Allegra42/ZEReader-KiCad/pictures/ze-back.png

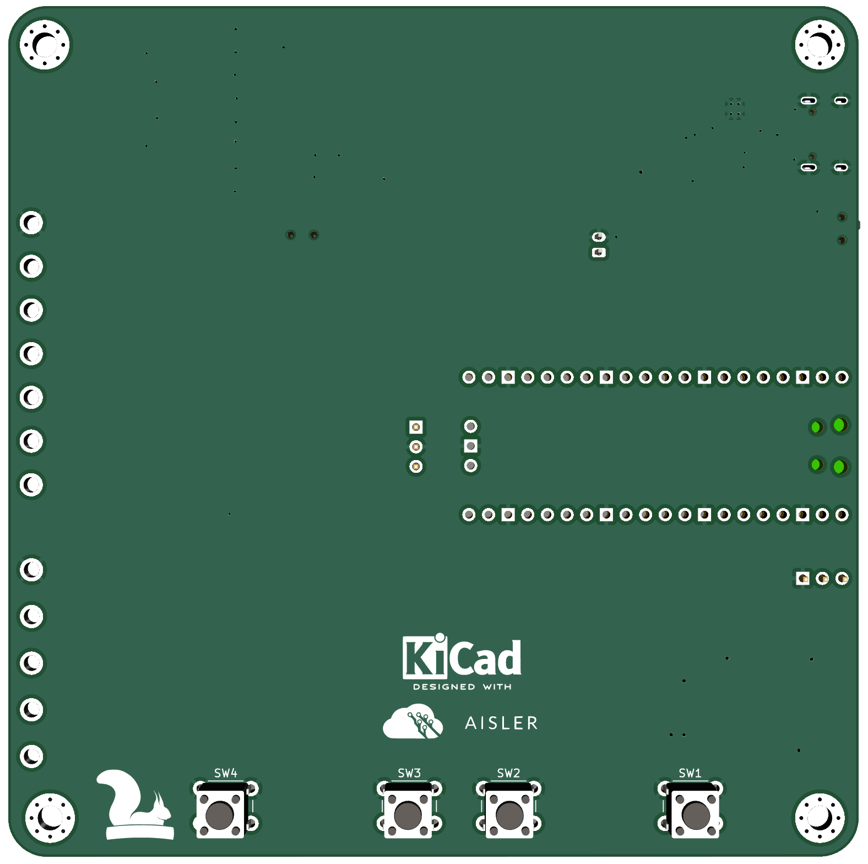
pictures/ze-back.png
