Allegra42/ZEReader-KiCad/pictures/ze-front.png

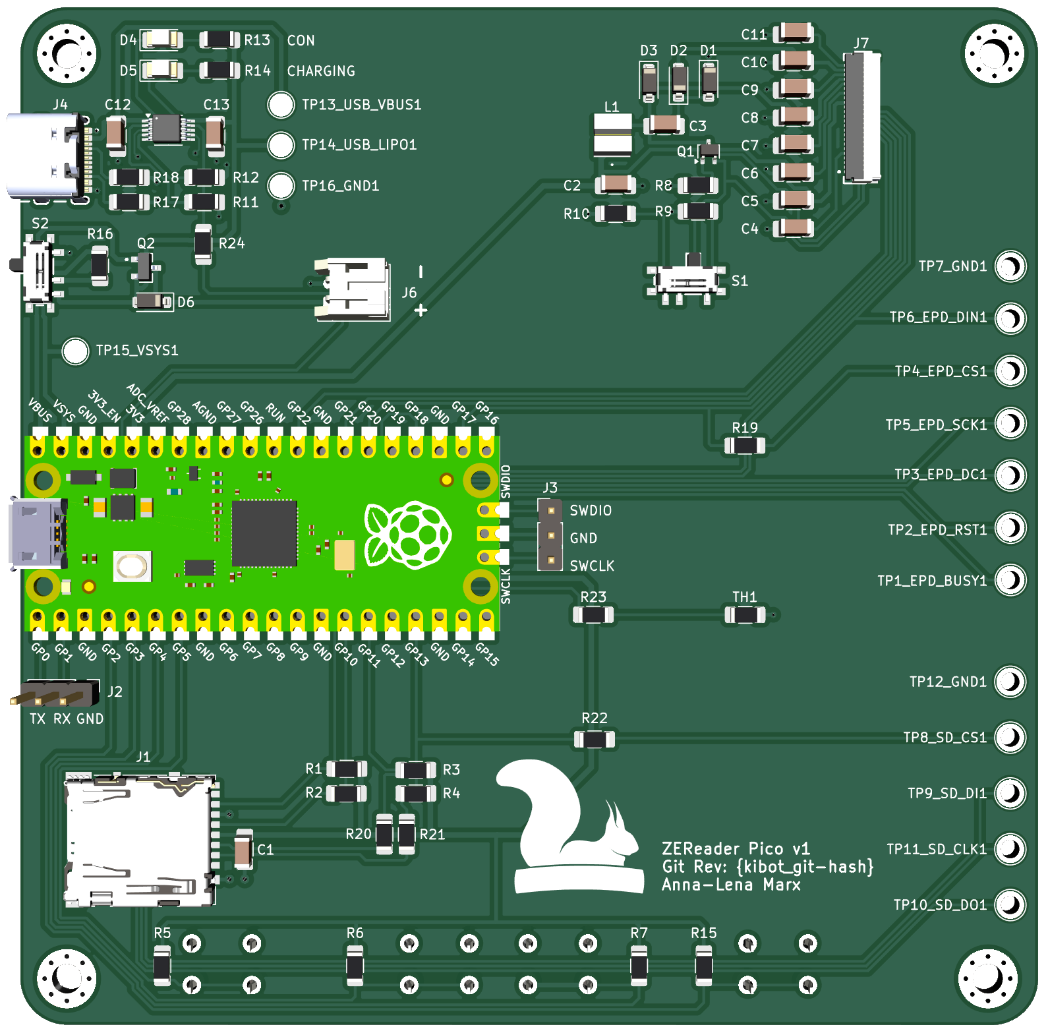
pictures/ze-front.png
