Allegra42/ZEReader-KiCad/pictures/ze-pcb.png

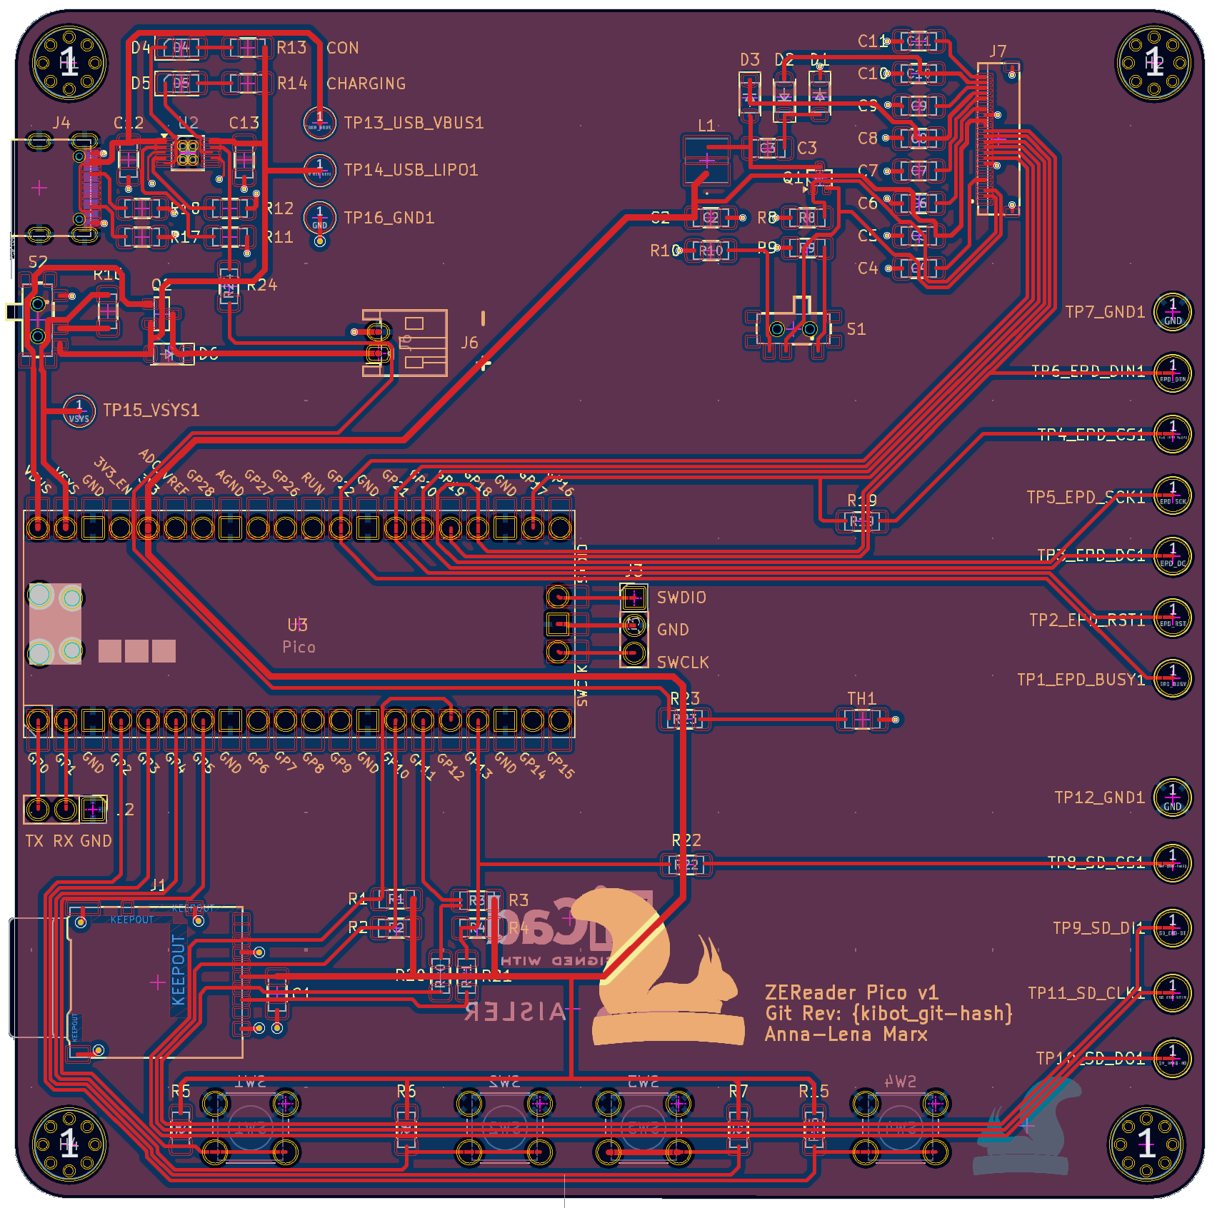
pictures/ze-pcb.png
