Allegra42/ZEReader-KiCad/pictures/ze-ray-back.png

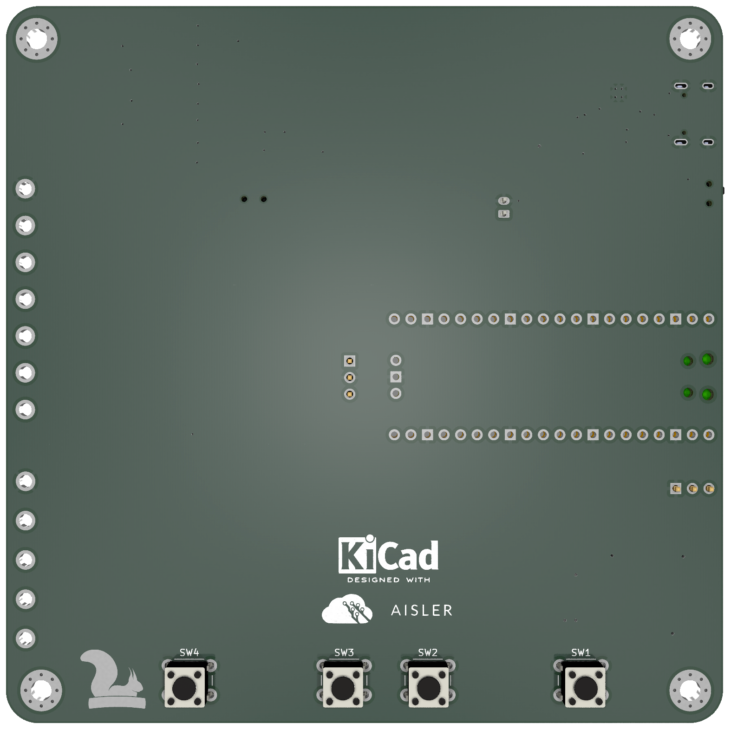
pictures/ze-ray-back.png
