Allegra42/ZEReader-KiCad/pictures/ZEReader-Pico v2-back.png

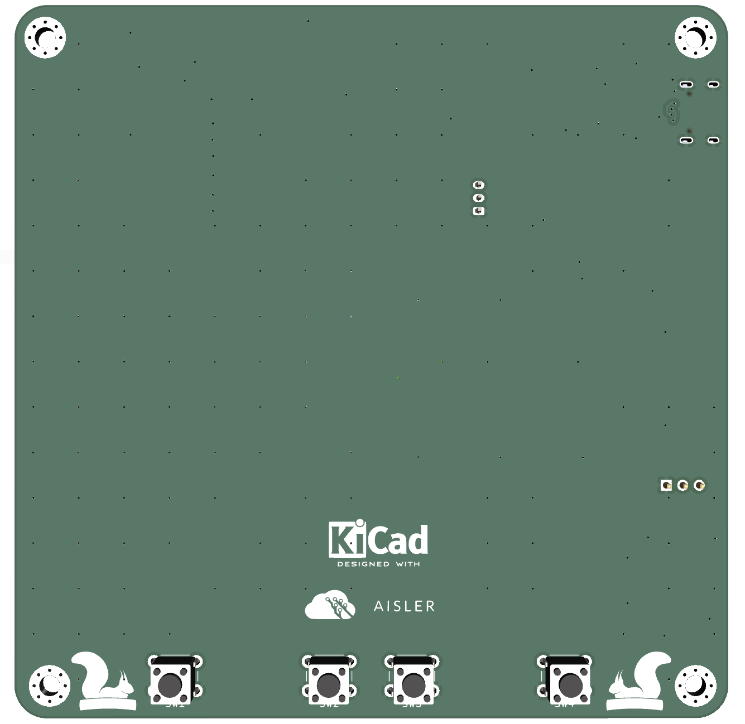
pictures/ZEReader-Pico v2-back.png
