Allegra42/ZEReader-KiCad/ZEReader-Pico.kicad_pcb

## KiCad design ZEReader-Pico.kicad_pcb (2026-01-08)

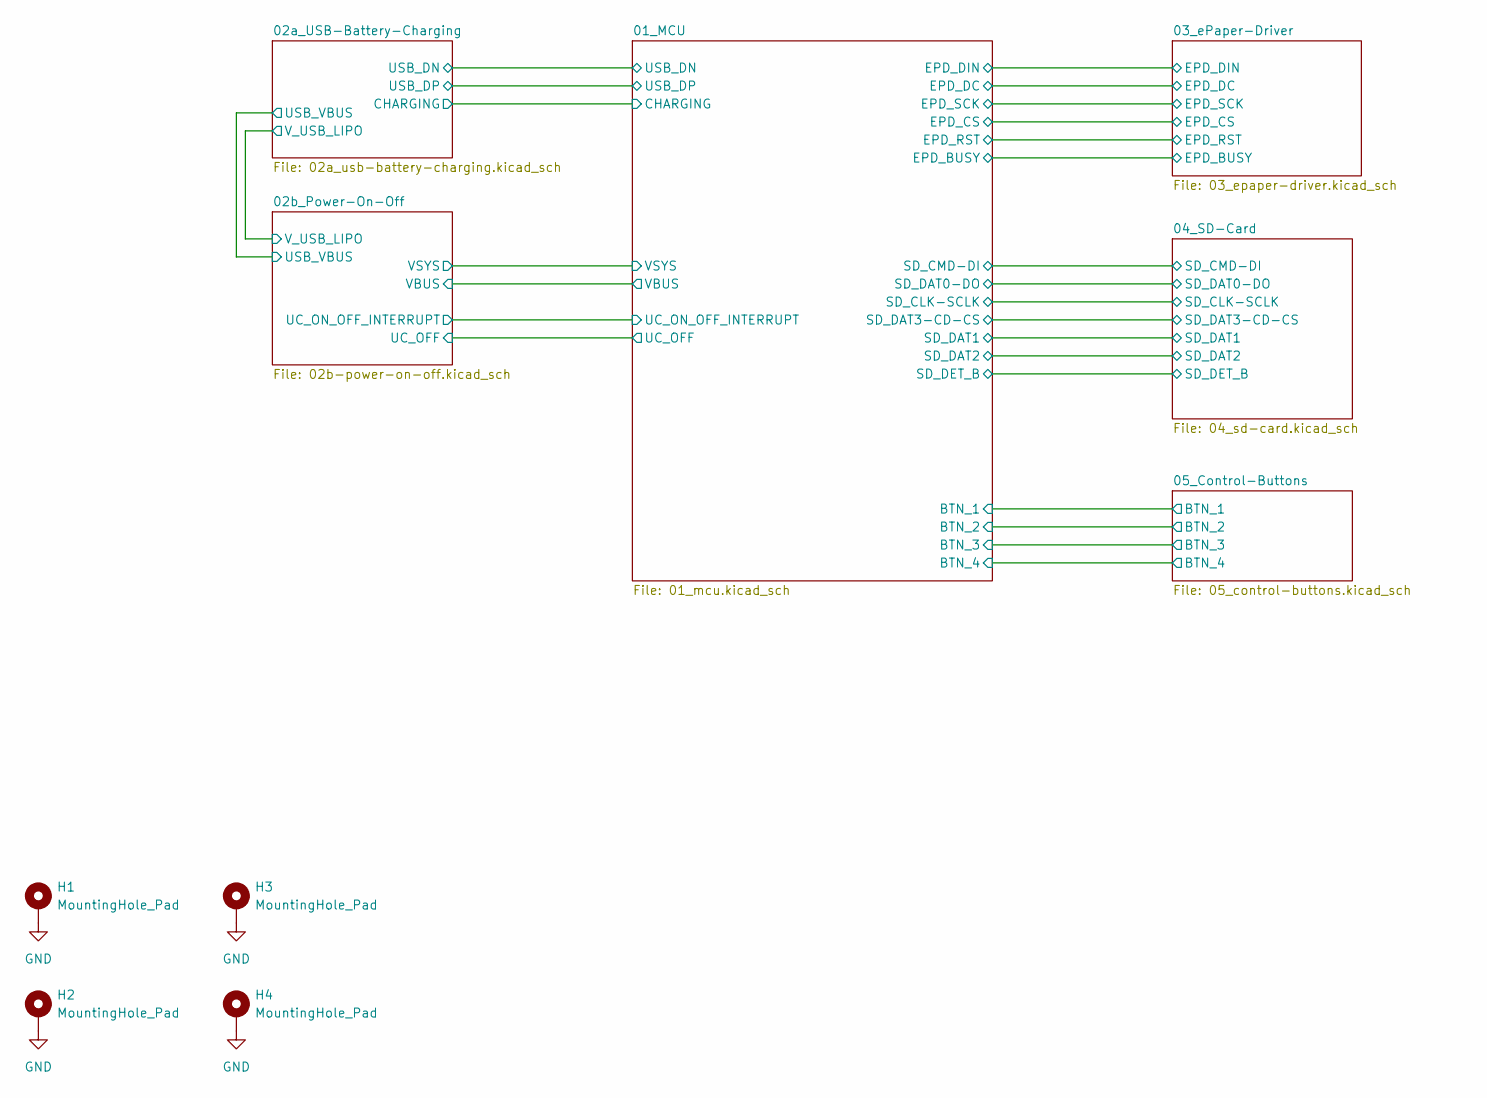
[picture p8: schematic ZEReader-Pico.kicad_sch]

Parts:
H1, H2, H3, H4: MountingHole_Pad; MountingHole_3.2mm_M3_Pad_Via

Connections:
GND: H1.1, H2.1, H3.1, H4.1; also elsewhere on the board

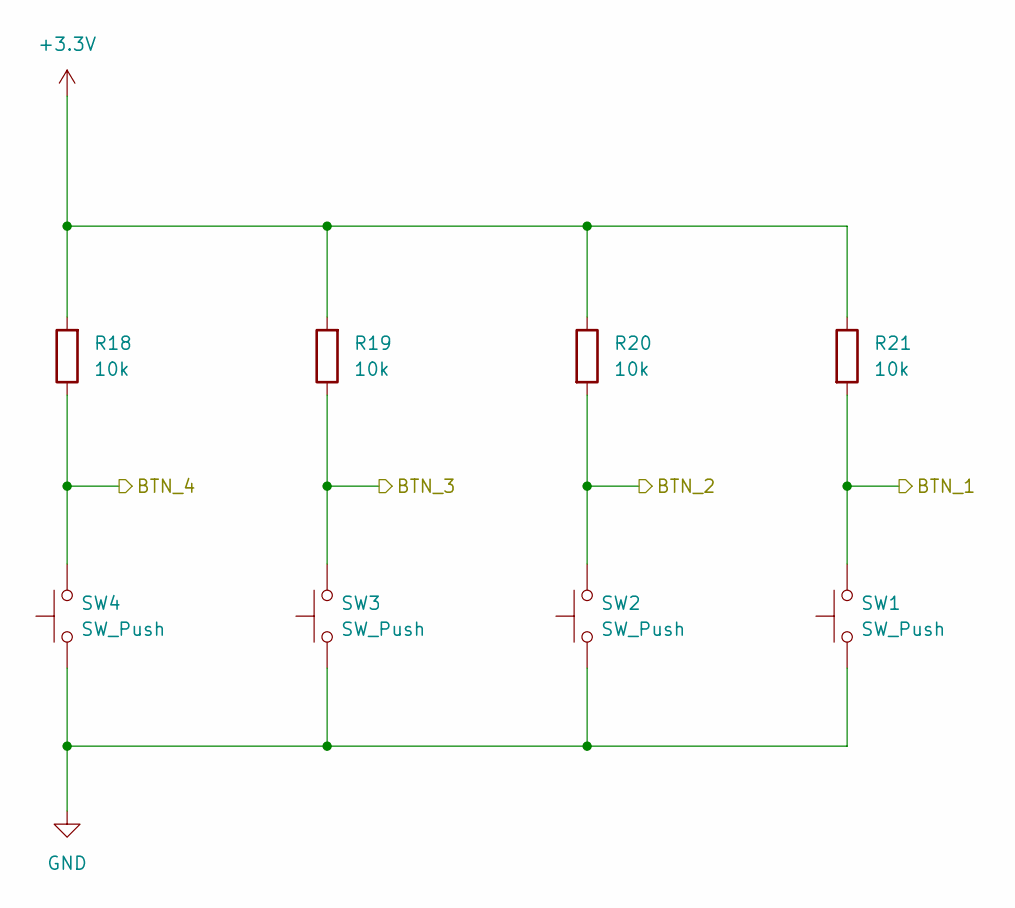
[picture p9: schematic 05_control-buttons.kicad_sch, ZEReader-Pico]

Parts:
R18, R19, R20, R21: 10k; R_1206_3216Metric_Pad1.30x1.75mm_HandSolder; Manufacturer PartNo RC1206FR-0710KL; DigiKey 311-10.0KFRCT-ND
SW1, SW2, SW3, SW4: SW_Push; SW_PUSH_6mm; Manufacturer PartNo 1825910-6; DigiKey 450-1650-ND

Connections:
+3.3V: R18.2, R19.2, R20.1, R21.1; also elsewhere on the board
/01_MCU/BTN_1: R21.2, SW1.2; also elsewhere on the board
/01_MCU/BTN_2: R20.2, SW2.2; also elsewhere on the board
/01_MCU/BTN_3: R19.1, SW3.2; also elsewhere on the board
/01_MCU/BTN_4: R18.1, SW4.2; also elsewhere on the board
GND: SW1.1, SW2.1, SW3.1, SW4.1; also elsewhere on the board

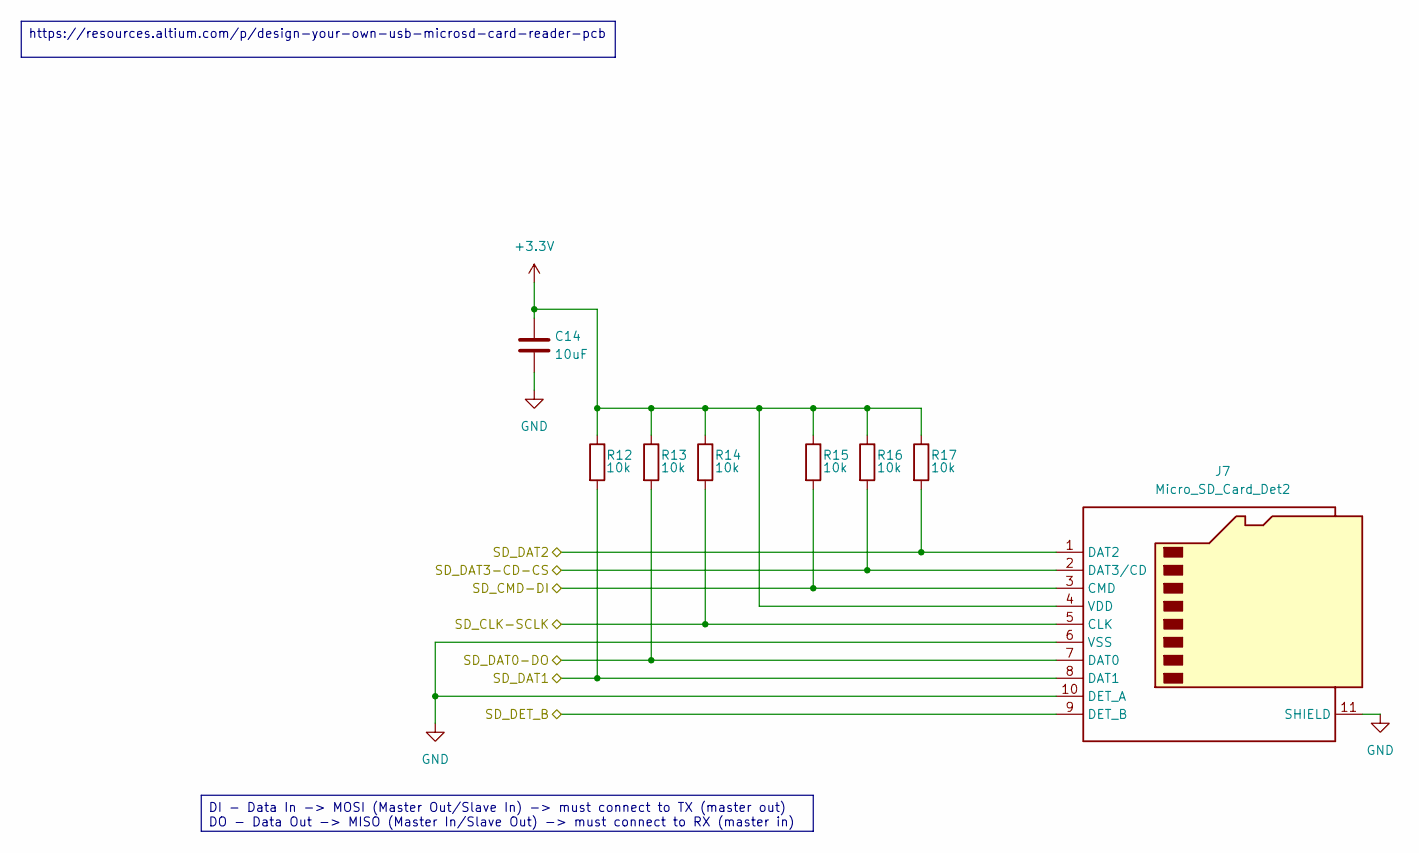
[picture p10: schematic 04_sd-card.kicad_sch, ZEReader-Pico]

Parts:
C14: 10uF; C_1206_3216Metric_Pad1.33x1.80mm_HandSolder; Manufacturer PartNo CL31B106KAHNNNE; DigiKey 1276-1804-1-ND
J7: Micro_SD_Card_Det2; microSD_HC_Hirose_DM3AT-SF-PEJM5; Manufacturer PartNo DM3AT-SF-PEJM5; DigiKey HR1964CT-ND
R12, R13, R14, R15, R16, R17: 10k; R_1206_3216Metric_Pad1.30x1.75mm_HandSolder; Manufacturer PartNo RC1206FR-0710KL; DigiKey 311-10.0KFRCT-ND

Connections:
+3.3V: C14.1, J7.4 (VDD), R12.1, R13.1, R14.1, R15.1, R16.1, R17.1; also elsewhere on the board
/01_MCU/SD_CLK-SCLK: J7.5 (CLK), R14.2; also elsewhere on the board
/01_MCU/SD_CMD-DI: J7.3 (CMD), R15.2; also elsewhere on the board
/01_MCU/SD_DAT0-DO: J7.7 (DAT0), R13.2; also elsewhere on the board
/01_MCU/SD_DAT1: J7.8 (DAT1), R12.2; also elsewhere on the board
/01_MCU/SD_DAT2: J7.1 (DAT2), R17.2; also elsewhere on the board
/01_MCU/SD_DAT3-CD-CS: J7.2 (DAT3/CD), R16.2; also elsewhere on the board
/01_MCU/SD_DET_B: J7.9 (DET_B); also elsewhere on the board
GND: C14.2, J7.6 (VSS), J7.10 (DET_A), J7.11 (SHIELD); also elsewhere on the board

Notes on the sheet:
DI - Data In -> MOSI (Master Out/Slave In) -> must connect to TX (master out) DO - Data Out -> MISO (Master In/Slave Out) -> must connect to RX (master in)
https://resources.altium.com/p/design-your-own-usb-microsd-card-reader-pcb

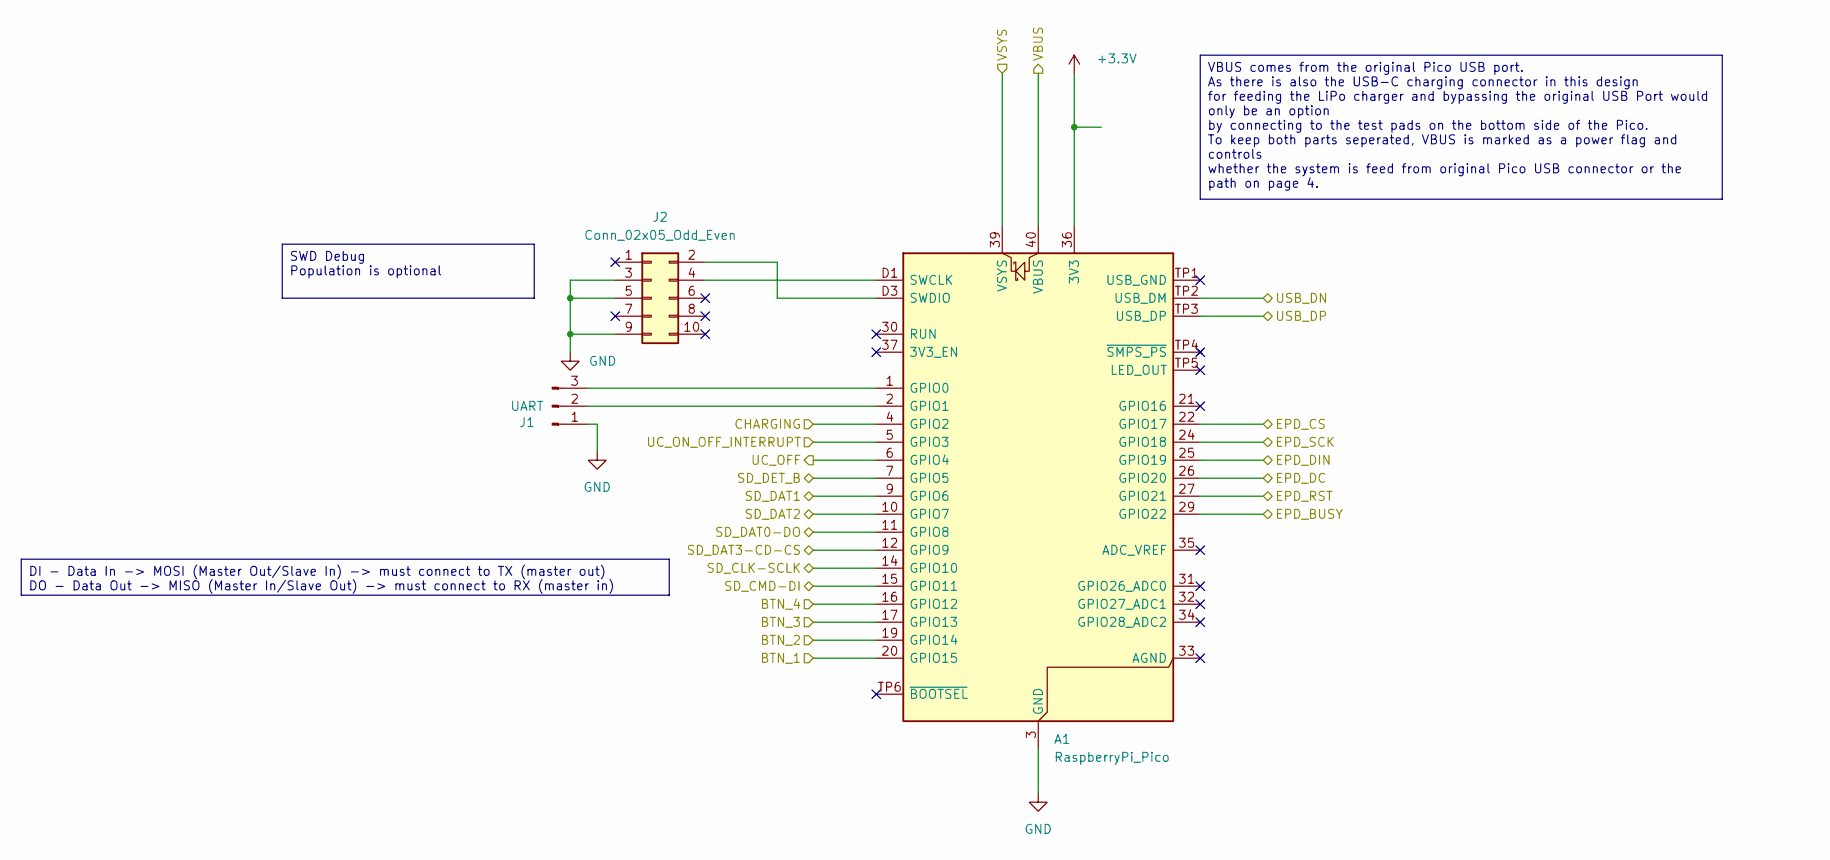
[picture p11: schematic 01_mcu.kicad_sch, ZEReader-Pico]

Parts:
A1: RaspberryPi_Pico; RaspberryPi_Pico_SMD; Manufacturer PartNo SC1631; DigiKey 2648-SC1631CT-ND
J1: UART; PinHeader_1x03_P2.54mm_Vertical; Manufacturer PartNo G800W305018EU; DigiKey 664-G800W305018EU-ND
J2: Conn_02x05_Odd_Even; PinHeader_2x05_P1.27mm_Vertical_SMD; Manufacturer PartNo BD125-10-A-0305-0580-L-B; DigiKey 2073-BD125-10-A-0305-0580-L-BCT-ND

Connections:
+3.3V: A1.36 (3V3); also elsewhere on the board
/01_MCU/BTN_1: A1.20 (GPIO15); also elsewhere on the board
/01_MCU/BTN_2: A1.19 (GPIO14); also elsewhere on the board
/01_MCU/BTN_3: A1.17 (GPIO13); also elsewhere on the board
/01_MCU/BTN_4: A1.16 (GPIO12); also elsewhere on the board
/01_MCU/CHARGING: A1.4 (GPIO2); also elsewhere on the board
/01_MCU/EPD_BUSY: A1.29 (GPIO22); also elsewhere on the board
/01_MCU/EPD_CS: A1.22 (GPIO17); also elsewhere on the board
/01_MCU/EPD_DC: A1.26 (GPIO20); also elsewhere on the board
/01_MCU/EPD_DIN: A1.25 (GPIO19); also elsewhere on the board
/01_MCU/EPD_RST: A1.27 (GPIO21); also elsewhere on the board
/01_MCU/EPD_SCK: A1.24 (GPIO18); also elsewhere on the board
/01_MCU/SD_CLK-SCLK: A1.14 (GPIO10); also elsewhere on the board
/01_MCU/SD_CMD-DI: A1.15 (GPIO11); also elsewhere on the board
/01_MCU/SD_DAT0-DO: A1.11 (GPIO8); also elsewhere on the board
/01_MCU/SD_DAT1: A1.9 (GPIO6); also elsewhere on the board
/01_MCU/SD_DAT2: A1.10 (GPIO7); also elsewhere on the board
/01_MCU/SD_DAT3-CD-CS: A1.12 (GPIO9); also elsewhere on the board
/01_MCU/SD_DET_B: A1.7 (GPIO5); also elsewhere on the board
/01_MCU/UC_OFF: A1.6 (GPIO4); also elsewhere on the board
/01_MCU/UC_ON_OFF_INTERRUPT: A1.5 (GPIO3); also elsewhere on the board
/01_MCU/USB_DN: A1.TP2 (USB_DM); also elsewhere on the board
/01_MCU/USB_DP: A1.TP3 (USB_DP); also elsewhere on the board
/01_MCU/VBUS: A1.40 (VBUS); also elsewhere on the board
/01_MCU/VSYS: A1.39 (VSYS); also elsewhere on the board
GND: A1.3 (GND), A1.8 (GND), A1.13 (GND), A1.18 (GND), A1.23 (GND), A1.28 (GND), A1.38 (GND), A1.D2 (GND), J1.1, J2.3, J2.5, J2.9; also elsewhere on the board
unnamed: A1.1 (GPIO0), J1.3
unnamed: A1.2 (GPIO1), J1.2
unnamed: A1.D1 (SWCLK), J2.4
unnamed: A1.D3 (SWDIO), J2.2

Notes on the sheet:
VBUS comes from the original Pico USB port. As there is also the USB-C charging connector in this design for feeding the LiPo charger and bypassing the original USB Port would only be an option by connecting to the test pads on the bottom side of the Pico. To keep both parts seperated, VBUS is mark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
DI - Data In -> MOSI (Master Out/Slave In) -> must connect to TX (master out) DO - Data Out -> MISO (Master In/Slave Out) -> must connect to RX (master in)
SWD Debug Population is optional

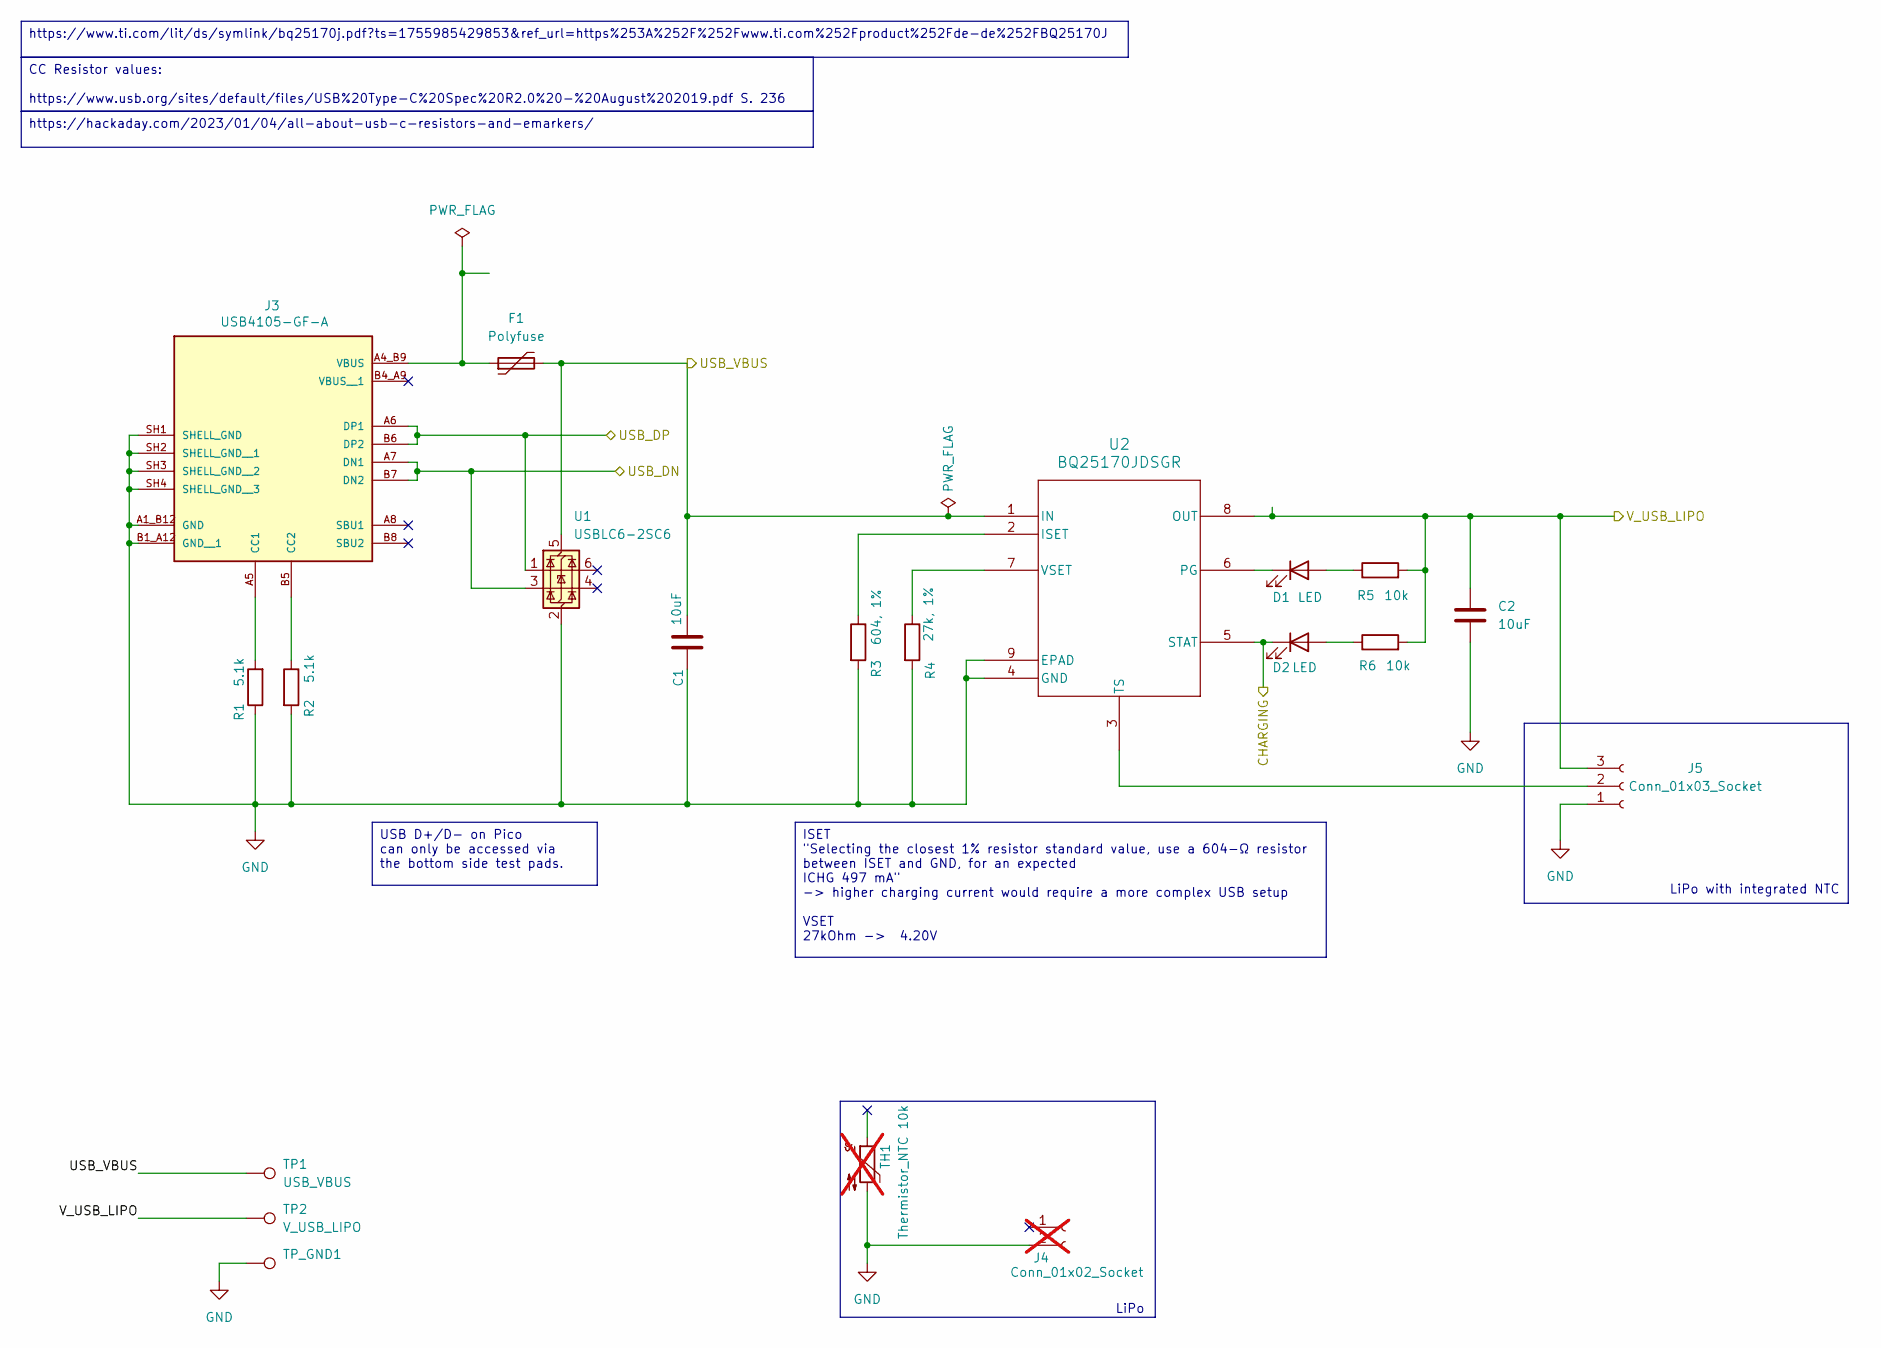
[picture p12: schematic 02a_usb-battery-charging.kicad_sch, ZEReader-Pico]

Parts:
C1, C2: 10uF; C_1206_3216Metric_Pad1.33x1.80mm_HandSolder; Manufacturer PartNo CL31B106KAHNNNE; DigiKey 1276-1804-1-ND
D1: LED; LED_1206_3216Metric_Pad1.42x1.75mm_HandSolder; Manufacturer PartNo 150120YS75000; DigiKey 732-4994-1-ND
D2: LED; LED_1206_3216Metric_Pad1.42x1.75mm_HandSolder; Manufacturer PartNo 150120GS75000; DigiKey 732-4990-1-ND
F1: Polyfuse; R_1206_3216Metric_Pad1.30x1.75mm_HandSolder; Manufacturer PartNo 1206L050/15YR; DigiKey F3733CT-ND
J3: USB4105-GF-A; GCT_USB4105-GF-A; PARTREV B4; DigiKey 2073-USB4105-GF-ACT-ND
J4: Conn_01x02_Socket; JST_PH_S2B-PH-K_1x02_P2.00mm_Horizontal; not fitted
J5: Conn_01x03_Socket; JST_PH_S3B-PH-K_1x03_P2.00mm_Horizontal; Manufacturer PartNo S3B-PH-K-S; DigiKey 455-1720-ND
R1, R2: 5.1k; R_1206_3216Metric_Pad1.30x1.75mm_HandSolder; Manufacturer PartNo AC1206FR-075K1L; DigiKey YAG3894CT-ND
R3: 604, 1%; R_1206_3216Metric_Pad1.30x1.75mm_HandSolder; Manufacturer PartNo RNCP1206FTD604R; DigiKey RNCP1206FTD604RCT-ND
R4: 27k, 1%; R_1206_3216Metric_Pad1.30x1.75mm_HandSolder; Manufacturer PartNo RC1206FR-0727KL; DigiKey 311-27.0KFRCT-ND
R5, R6: 10k; R_1206_3216Metric_Pad1.30x1.75mm_HandSolder; Manufacturer PartNo RC1206FR-0710KL; DigiKey 311-10.0KFRCT-ND
TH1: Thermistor_NTC 10k; R_1206_3216Metric_Pad1.30x1.75mm_HandSolder; not fitted
TP1: USB_VBUS; TestPoint_Pad_D2.5mm
TP2: V_USB_LIPO; TestPoint_Pad_D2.5mm
TP_GND1: TestPoint_Pad_D2.5mm
U1: USBLC6-2SC6; SOT-23-6; Manufacturer PartNo USBLC6-2SC6; DigiKey 497-5235-1-ND
U2: BQ25170JDSGR; WSON8_BQ2517_TEX; Manufacturer PartNo BQ25170JDSGR; DigiKey 296-BQ25170JDSGRCT-ND

Connections:
/01_MCU/CHARGING: D2.1 (K), U2.5 (STAT); also elsewhere on the board
/01_MCU/USB_DN: J3.A7 (DN1), J3.B7 (DN2), U1.3 (I/O2); also elsewhere on the board
/01_MCU/USB_DP: J3.A6 (DP1), J3.B6 (DP2), U1.1 (I/O1); also elsewhere on the board
/02a_USB-Battery-Charging/USB_VBUS: C1.1, F1.2, TP1.1, U1.5 (VBUS), U2.1 (IN); also elsewhere on the board
/02a_USB-Battery-Charging/V_USB_LIPO: C2.1, J5.3, R5.2, R6.2, TP2.1, U2.8 (OUT); also elsewhere on the board
GND: C1.2, C2.2, J3.A1_B12 (GND), J3.B1_A12 (GND__1), J3.SH1 (SHELL_GND), J3.SH2 (SHELL_GND__1), J3.SH3 (SHELL_GND__2), J3.SH4 (SHELL_GND__3), J4.2, J5.1, R1.1, R2.2, R3.2, R4.2, TH1.2, TP_GND1.1, U1.2 (GND), U2.4 (GND), U2.9 (EPAD); also elsewhere on the board
unnamed: D1.2 (A), R5.1
unnamed: D1.1 (K), U2.6 (PG)
unnamed: D2.2 (A), R6.1
unnamed: J3.A5 (CC1), R1.2
unnamed: J3.B5 (CC2), R2.1
unnamed: F1.1, J3.A4_B9 (VBUS)
unnamed: J5.2, U2.3 (TS)
unnamed: R3.1, U2.2 (ISET)
unnamed: R4.1, U2.7 (VSET)

Notes on the sheet:
LiPo
LiPo with integrated NTC
CC Resistor values: https://www.usb.org/sites/default/files/USB%20Type-C%20Spec%20R2.0%20-%20August%202019.pdf S. 236
ISET "Selecting the closest 1% resistor standard value, use a 604-Ω resistor between ISET and GND, for an expected ICHG 497 mA" -> higher charging current would require a more complex USB setup VSET 27kOhm -> 4.20V
https://www.ti.com/lit/ds/symlink/bq25170j.pdf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
https://hackaday.com/2023/01/04/all-about-usb-c-resistors-and-emarkers/
USB D+/D- on Pico can only be accessed via the bottom side test pads.

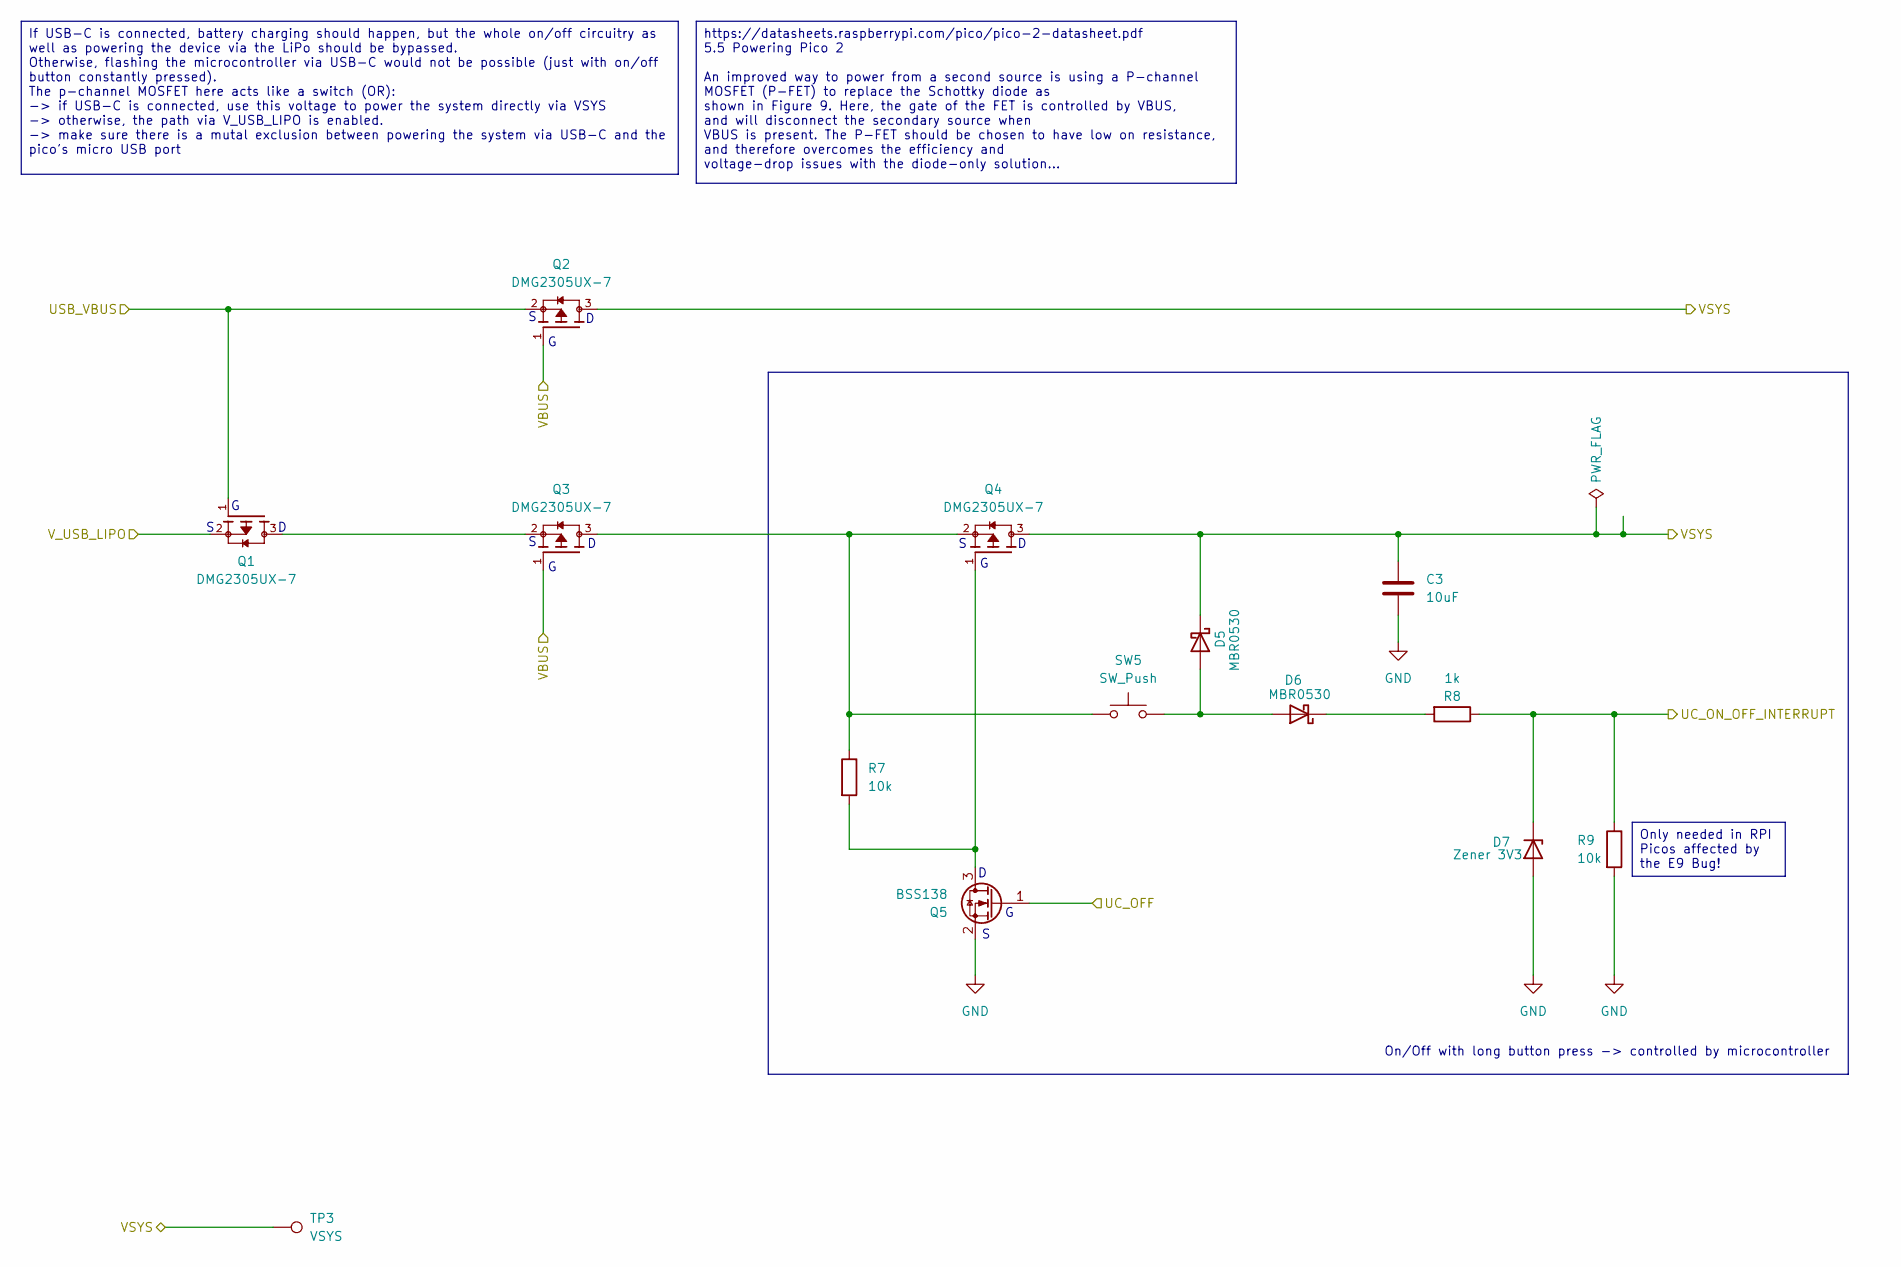
[picture p13: schematic 02b-power-on-off.kicad_sch]

Parts:
C3: 10uF; C_1206_3216Metric_Pad1.33x1.80mm_HandSolder; Manufacturer PartNo CL31B106KAHNNNE; DigiKey 1276-1804-1-ND
D5, D6: MBR0530; D_SOD-123; Manufacturer PartNo MBR0530T1G; DigiKey MBR0530T1GOSCT-ND
D7: Zener 3V3; DIO_TDZVT_ROM; Manufacturer PartNo TFZVTR3.3B; DigiKey TFZVTR3.3BCT-ND
Q1, Q2, Q3, Q4: DMG2305UX-7; SOT-23-3; PARTREV 09/2018; DigiKey DMG2305UX-7DICT-ND
Q5: BSS138; SOT-23; Manufacturer PartNo BSS138LT3G; DigiKey BSS138LT3GOSCT-ND
R7, R9: 10k; R_1206_3216Metric_Pad1.30x1.75mm_HandSolder; Manufacturer PartNo RC1206FR-0710KL; DigiKey 311-10.0KFRCT-ND
R8: 1k; R_1206_3216Metric_Pad1.30x1.75mm_HandSolder; Manufacturer PartNo RNCP1206FTD1K00; DigiKey RNCP1206FTD1K00CT-ND
SW5: SW_Push; SW_Push_1P1T_NO_E-Switch_TL3301NxxxxxG; Manufacturer PartNo TL3301NF100QG; DigiKey EG6054CT-ND
TP3: VSYS; TestPoint_Pad_D2.5mm

Connections:
/01_MCU/UC_OFF: Q5.1 (G); also elsewhere on the board
/01_MCU/UC_ON_OFF_INTERRUPT: D7.1 (K), R8.1, R9.1; also elsewhere on the board
/01_MCU/VBUS: Q2.1, Q3.1; also elsewhere on the board
/01_MCU/VSYS: C3.1, D5.1 (K), Q2.3, Q4.3, TP3.1; also elsewhere on the board
/02a_USB-Battery-Charging/USB_VBUS: Q1.1, Q2.2; also elsewhere on the board
/02a_USB-Battery-Charging/V_USB_LIPO: Q1.2; also elsewhere on the board
GND: C3.2, D7.2 (A), Q5.2 (S), R9.2; also elsewhere on the board
unnamed: D5.2 (A), D6.2 (A), SW5.2
unnamed: D6.1 (K), R8.2
unnamed: Q1.3, Q3.2
unnamed: Q3.3, Q4.2, R7.1, SW5.1
unnamed: Q4.1, Q5.3 (D), R7.2

Notes on the sheet:
On/Off with long button press -> controlled by microcontroller
If USB-C is connected, battery charging should happen, but the whole on/off circuitry as well as powering the device via the LiPo should be bypassed. Otherwise, flashing the microcontroller via USB-C would not be possible (just with on/off button constantly pressed). The p-channel MOSFET here acts 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
https://datasheets.raspberrypi.com/pico/pico-2-datasheet.pdf 5.5 Powering Pico 2 An improved way to power from a second source is using a P-channel MOSFET (P-FET) to replace the Schottky diode as shown in Figure 9. Here, the gate of the FET is controlled by VBUS, and will disconnect the secondary s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
Only needed in RPI Picos affected by the E9 Bug!

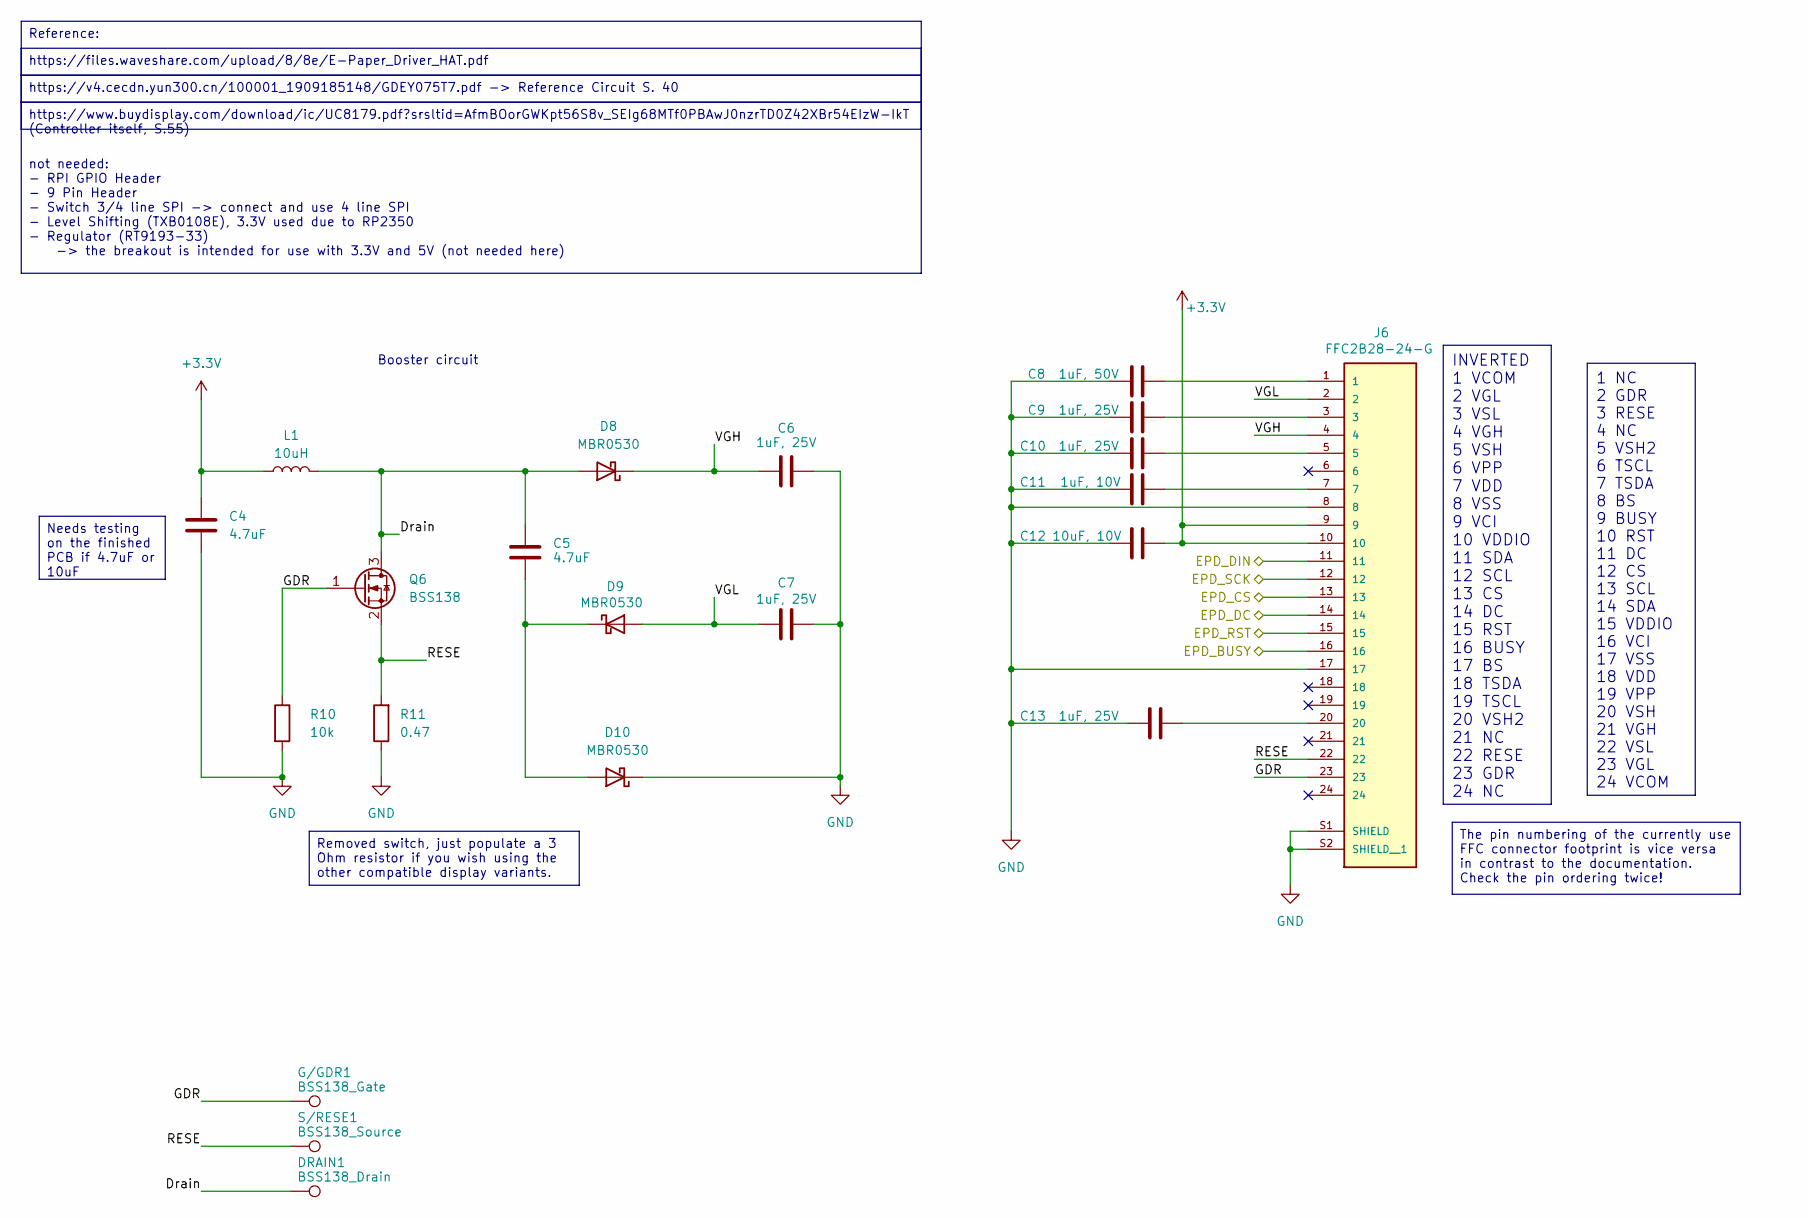
[picture p14: schematic 03_epaper-driver.kicad_sch, ZEReader-Pico]

Parts:
C4, C5: 4.7uF; C_1206_3216Metric_Pad1.33x1.80mm_HandSolder; Manufacturer PartNo CL31B475KBHNFNE; DigiKey 1276-3179-1-ND
C6, C7, C9, C10, C13: 1uF, 25V; C_1206_3216Metric_Pad1.33x1.80mm_HandSolder; Manufacturer PartNo CL31B105KBHNFNE; DigiKey 1276-3091-1-ND
C8: 1uF, 50V; C_1206_3216Metric_Pad1.33x1.80mm_HandSolder; Manufacturer PartNo CL31B105KBHNFNE; DigiKey 1276-3091-1-ND
C11: 1uF, 10V; C_1206_3216Metric_Pad1.33x1.80mm_HandSolder; Manufacturer PartNo CL31B105KBHNFNE; DigiKey 1276-3091-1-ND
C12: 10uF, 10V; C_1206_3216Metric_Pad1.33x1.80mm_HandSolder; Manufacturer PartNo CL31B106KAHNNNE; DigiKey 1276-1804-1-ND
D8, D9, D10: MBR0530; D_SOD-123; Manufacturer PartNo MBR0530T1G; DigiKey MBR0530T1GOSCT-ND
DRAIN1: BSS138_Drain; TestPoint_Pad_D2.5mm
G/GDR1: BSS138_Gate; TestPoint_Pad_D2.5mm
J6: FFC2B28-24-G; GCT_FFC2B28-24-G; PARTREV A; DigiKey 2073-FFC2B28-24-GCT-ND
L1: 10uH; IND_IFSC_1515AH_VIS-L; Manufacturer PartNo IFSC1515AHER100M01; DigiKey 541-1406-1-ND
Q6: BSS138; SOT-23; Manufacturer PartNo BSS138LT3G; DigiKey BSS138LT3GOSCT-ND
R10: 10k; R_1206_3216Metric_Pad1.30x1.75mm_HandSolder; Manufacturer PartNo RC1206FR-0710KL; DigiKey 311-10.0KFRCT-ND
R11: 0.47; R_1206_3216Metric_Pad1.30x1.75mm_HandSolder; Manufacturer PartNo KDV12DR470ET; DigiKey 273-KDV12DR470ETCT-ND
S/RESE1: BSS138_Source; TestPoint_Pad_D2.5mm

Connections:
+3.3V: C4.1, C12.2, J6.9, J6.10, L1.1; also elsewhere on the board
/01_MCU/EPD_BUSY: J6.16; also elsewhere on the board
/01_MCU/EPD_CS: J6.13; also elsewhere on the board
/01_MCU/EPD_DC: J6.14; also elsewhere on the board
/01_MCU/EPD_DIN: J6.11; also elsewhere on the board
/01_MCU/EPD_RST: J6.15; also elsewhere on the board
/01_MCU/EPD_SCK: J6.12; also elsewhere on the board
/03_ePaper-Driver/Drain: C5.1, D8.2 (A), DRAIN1.1, L1.2, Q6.3 (D)
/03_ePaper-Driver/GDR: G/GDR1.1, J6.23, Q6.1 (G), R10.1
/03_ePaper-Driver/RESE: J6.22, Q6.2 (S), R11.2, S/RESE1.1
/03_ePaper-Driver/VGH: C6.1, D8.1 (K), J6.4
/03_ePaper-Driver/VGL: C7.1, D9.2 (A), J6.2
GND: C4.2, C6.2, C7.2, C8.1, C9.1, C10.1, C11.1, C12.1, C13.1, D10.1 (K), J6.8, J6.17, J6.S1 (SHIELD), J6.S2 (SHIELD__1), R10.2, R11.1; also elsewhere on the board
unnamed: C8.2, J6.1
unnamed: C9.2, J6.3
unnamed: C10.2, J6.5
unnamed: C11.2, J6.7
unnamed: C13.2, J6.20
unnamed: C5.2, D9.1 (K), D10.2 (A)

Notes on the sheet:
Booster circuit
https://files.waveshare.com/upload/8/8e/E-Paper_Driver_HAT.pdf
INVERTED 1 VCOM 2 VGL 3 VSL 4 VGH 5 VSH 6 VPP 7 VDD 8 VSS 9 VCI 10 VDDIO 11 SDA 12 SCL 13 CS 14 DC 15 RST 16 BUSY 17 BS 18 TSDA 19 TSCL 20 VSH2 21 NC 22 RESE 23 GDR 24 NC
https://v4.cecdn.yun300.cn/100001_1909185148/GDEY075T7.pdf -> Reference Circuit S. 40
Needs testing on the finished PCB if 4.7uF or 10uF
https://www.buydisplay.com/download/ic/UC8179.pdf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 (Controller itself, S.55)
Removed switch, just populate a 3 Ohm resistor if you wish using the other compatible display variants.
The pin numbering of the currently use FFC connector footprint is vice versa in contrast to the documentation. Check the pin ordering twice!
1 NC 2 GDR 3 RESE 4 NC 5 VSH2 6 TSCL 7 TSDA 8 BS 9 BUSY 10 RST 11 DC 12 CS 13 SCL 14 SDA 15 VDDIO 16 VCI 17 VSS 18 VDD 19 VPP 20 VSH 21 VGH 22 VSL 23 VGL 24 VCOM
Reference: not needed: - RPI GPIO Header - 9 Pin Header - Switch 3/4 line SPI -> connect and use 4 line SPI - Level Shifting (TXB0108E), 3.3V used due to RP2350 - Regulator (RT9193-33) -> the breakout is intended for use with 3.3V and 5V (not needed here)
