Allegra42/ZEReader-KiCad/ZEReader-Pico.kicad_pcb

## KiCad design ZEReader-Pico.kicad_pcb (continued)

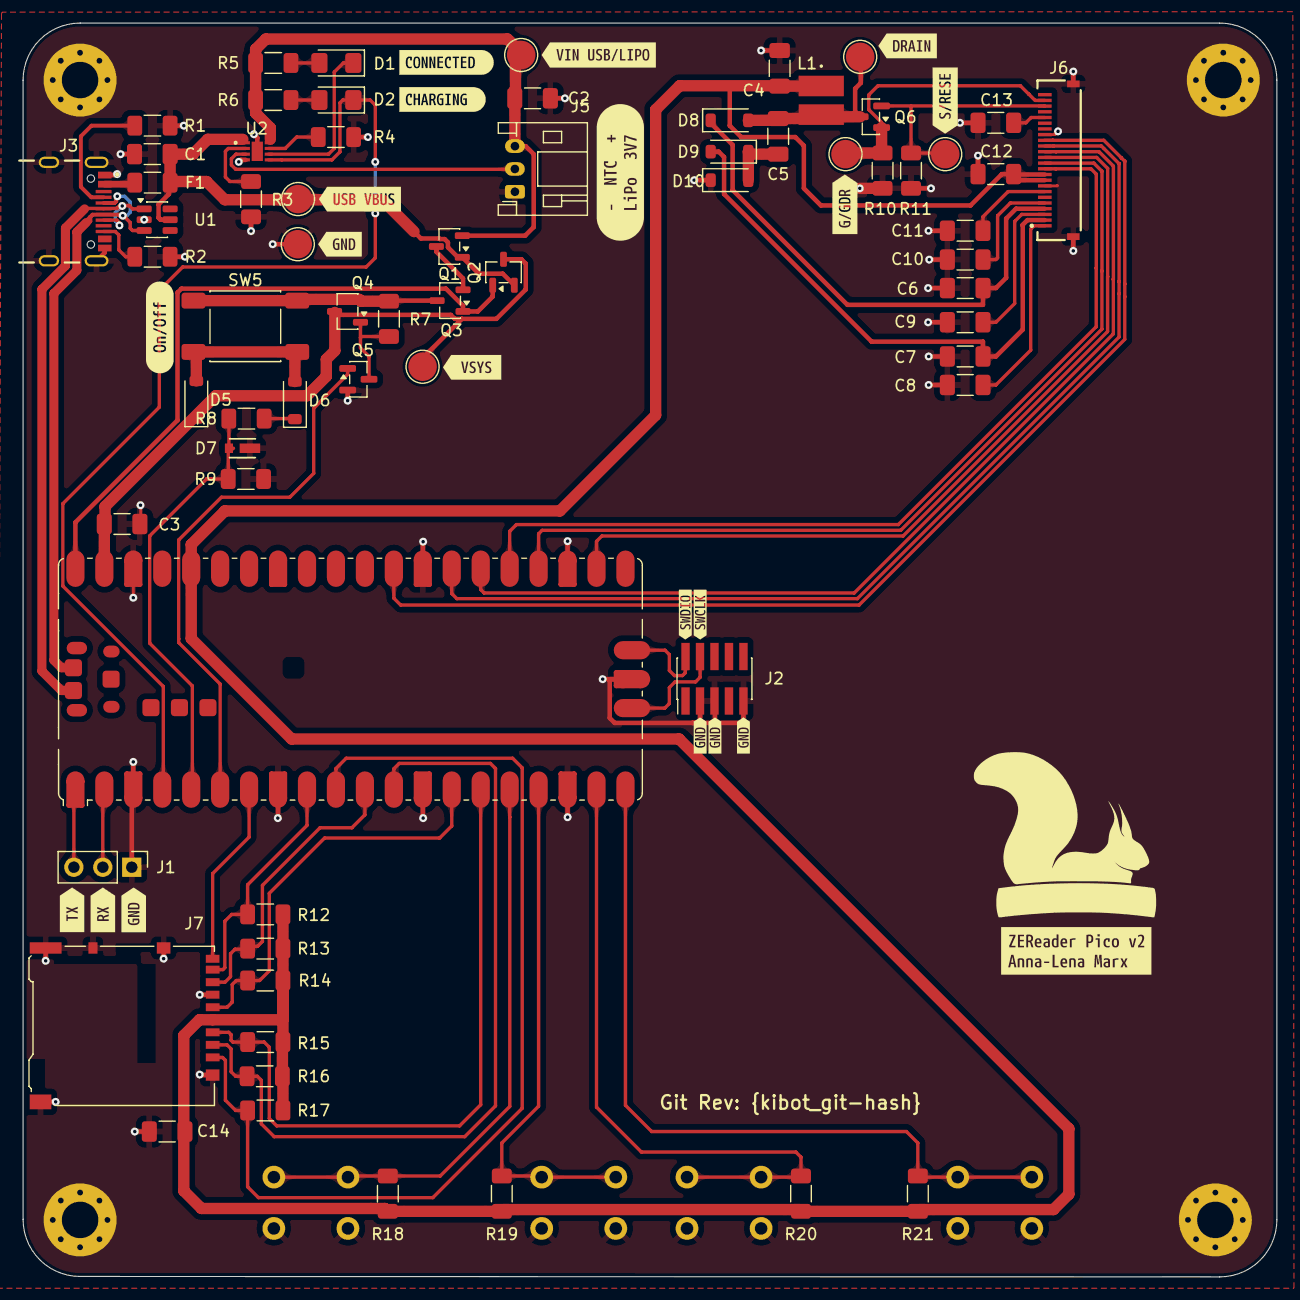
[picture p15: board ZEReader-Pico.kicad_pcb from above]

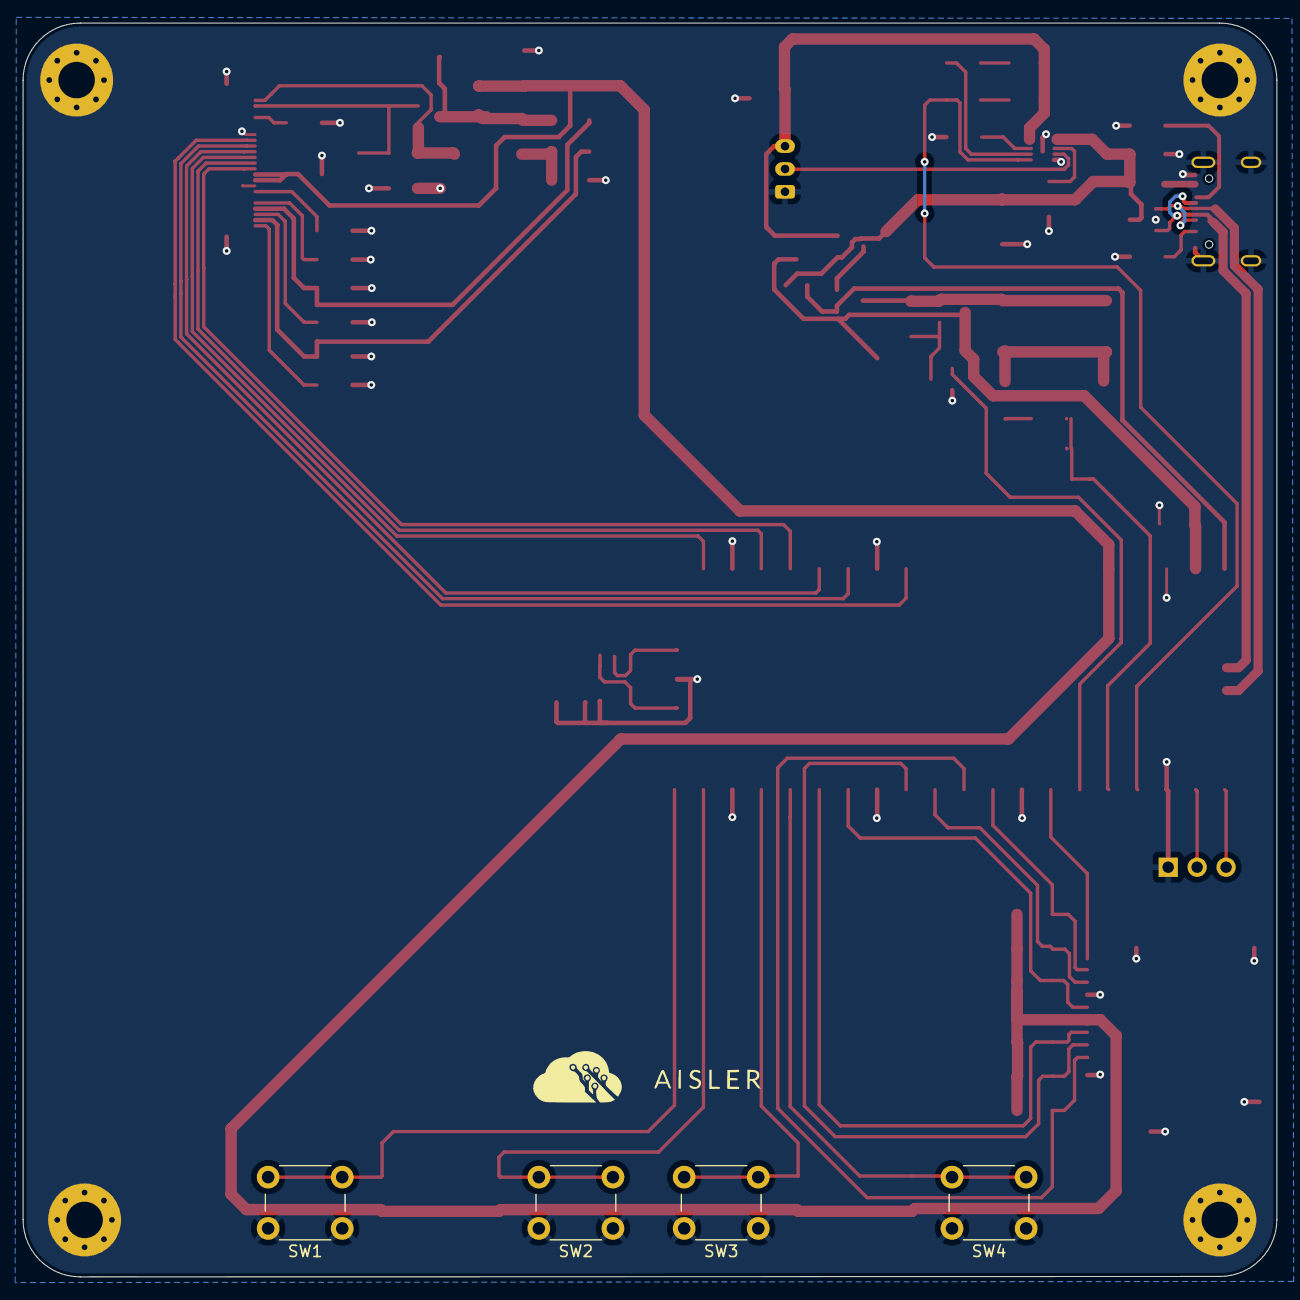
[picture p16: board ZEReader-Pico.kicad_pcb from below]

Board: 2 copper layers, 110.0 x 110.0 mm, 96 parts (4 on the bottom side), 57 nets.

Other parts of the board:
kibuzzard-1: G***; kibuzzard-6910EAB5
kibuzzard-2: G***; kibuzzard-6910F1E0
kibuzzard-3: G***; kibuzzard-6910EA92
kibuzzard-4: G***; kibuzzard-6910F073
kibuzzard-5: G***; kibuzzard-6910F03B
kibuzzard-6: G***; kibuzzard-6910EACE
kibuzzard-7: G***; kibuzzard-6910EA89
kibuzzard-8: G***; kibuzzard-6910EAAC
kibuzzard-10: G***; kibuzzard-6910EB09
kibuzzard-14: G***; kibuzzard-6910EC15
kibuzzard-15: G***; kibuzzard-6910EC3B
kibuzzard-16: G***; kibuzzard-6910EC48
kibuzzard-17: G***; kibuzzard-6910ECBF
kibuzzard-691E57BD: G***; kibuzzard-691E57BD
kibuzzard-691E5833: G***; kibuzzard-691E5833
kibuzzard-691EE38D: G***; kibuzzard-691EE38D
kibuzzard-691EE385: G***; kibuzzard-691EE385
kibuzzard-691EE480: G***; kibuzzard-691EE480
kibuzzard-691EE489: G***; kibuzzard-691EE489
kibuzzard-691EE495: G***; kibuzzard-691EE495
