Allegra42/ZEReader-KiCad/zereader-pico.kibot.yaml

kibot:
  version: 1

globals:
  # filters:

  # This will undo the 'set_text_variables' task when running locally
  restore_project: true

preflight:
  check_zone_fills: true

  erc:
    enabled: true
    dont_stop: true
  drc:
    enabled: true
    # Set some options to avoid stopping the KiBot run as the design is not finished yet
    dont_stop: true
    ignore_unconnected: false

  fill_zones: true
  update_xml: true

outputs:
  - name: 'IBoM'
    type: ibom
    dir: BoM
    options:
      extra_fields: "DigiKey,Manufacturer PartNo"

  - name: 'HTML BoM'
    type: bom
    dir: BoM
    options: &bom_options
      format: HTML
      columns:
        - _kicad_bom_fields

  - name: 'CSV BoM'
    type: bom
    dir: BoM
    options: &csv_bom_options
      format: CSV
      columns:
        - _kicad_bom_fields

  - name: 'Schematic'
    type: pdf_sch_print
    dir: Documentation

  - name: 'PCB Sheet'
    type: pcb_print
    dir: Documentation
    options:
      frame_plot_mechanism: 'gui'
      force_edge_cuts: true
      pages:
        - layers: 
          - layer: F.Cu
          - layer: F.SilkS 
          - layer: F.Mask
            color: '#14332440'
          - layer: Edge.Cuts
          - layer: F.Fab
          sheet: 'Top'
        - layers: 
          - layer: B.Cu
          - layer: B.SilkS
          - layer: B.Mask
            color: '#14332440'
          - layer: Edge.Cuts
          - layer: B.Fab
          sheet: 'Bottom'
          mirror: true

  - name: 'KiCad Board File'
    type: copy_files
    dir: 'KiCad'
    options:
      files:
        - source: "ZEReader-Pico.kicad_pcb"

  - name: 'Gerber'
    type: gerber
    dir: Gerber
    layers:
      - F.Cu
      - B.Cu
      - F.Paste
      - B.Paste
      - F.SilkS
      - B.SilkS
      - F.Mask
      - B.Mask
      - Edge.Cuts 

  - name: 'Drill'
    type: excellon
    dir: Drill
    options:
      metric_units: false
      minimal_header: true
      pth_and_npth_single_file: false
      pth_id: '-PTH'
      npth_id: '-NPTH'
      output: "%f%i.drl"

  - name: 'Netlist'
    type: netlist
    dir: Netlist
    options:
      format: ipc
      output: 'netlist.ipc'

  - name: 'Fab'
    type: compress
    dir: Fab
    options:
      format: ZIP
      files:
        - from_output: Gerber
          dest: /
        - from_output: Drill
          dest: /
        - from_output: Netlist
          dest: /
        - from_output: 'KiCad Board File'
          dest: /

  - name: 'Draw Top View'
    type: pcbdraw
    dir: PCB
    options:
      format: png
      dpi: 300

  - name: 'Draw Bottom View'
    type: pcbdraw
    dir: PCB
    options:
      format: png
      dpi: 300
      bottom: true

  - name: '3D Render Top'
    type: render_3d
    dir: PCB
    options:
      download: true
      view: 'top'
      ray_tracing: true
      height: 1080
      width: 1920

  - name: '3D Render Bottom'
    type: render_3d
    dir: PCB
    options:
      download: true
      view: 'bottom'
      ray_tracing: true
      height: 1080
      width: 1920

  - name: 'KiRi'
    type: kiri
    dir: KiRi
    layers: all
