Allegra42/ZEReader-KiCad/(commit log)

2025-01-26 Create inital KiCad hierarchical schematics structure
    [01_mcu.kicad_sch, 02_power.kicad_sch, 03_epaper-driver.kicad_sch, 04_sd-card.kicad_sch, 05_control-buttons.kicad_sch, ZEReader-Pico.kicad_pcb, ZEReader-Pico.kicad_sch]
2025-01-27 Adds SD card connector, control buttons and debug headers
    [01_mcu.kicad_sch, 04_sd-card.kicad_sch, 05_control-buttons.kicad_sch, ZEReader-Pico.kicad_pcb, ZEReader-Pico.kicad_sch]
2025-01-27 Add EPD Driver Circuit
    [01_mcu.kicad_sch, 03_epaper-driver.kicad_sch, 04_sd-card.kicad_sch, 05_control-buttons.kicad_sch, ZEReader-Pico.kicad_pcb, ZEReader-Pico.kicad_sch]
2025-01-29 Added USB-C, Battery Charging andOn/Off
    [01_mcu.kicad_sch, 02_power.kicad_sch, 04_sd-card.kicad_sch, 05_control-buttons.kicad_sch, ZEReader-Pico.kicad_pcb]
2025-01-30 Added some more notes, testpoints and rechecked footprints and parts
    [01_mcu.kicad_sch, 02_power.kicad_sch, 03_epaper-driver.kicad_sch, 04_sd-card.kicad_sch, 05_control-buttons.kicad_sch, ZEReader-Pico.kicad_pcb]
2025-01-31 Changed buttons to smaller ones, updated some comments
    [02_power.kicad_sch, 03_epaper-driver.kicad_sch, 04_sd-card.kicad_sch, 05_control-buttons.kicad_sch, ZEReader-Pico.kicad_pcb]
2025-02-03 Added CC line pulldown resistors
    [01_mcu.kicad_sch, 02_power.kicad_sch, 03_epaper-driver.kicad_sch, ZEReader-Pico.kicad_pcb]
2025-02-03 trigger KiBot test
    [01_mcu.kicad_sch]
2025-02-03 Proper KiBot variables
    [01_mcu.kicad_sch]
2025-02-03 Defined root schematic file
2025-02-03 fix: commented out not used filters section
    [zereader-pico.kibot.yaml]
2025-02-04 Add 3rd party symbols, footprints and 3d models to make the repo self-contained
    [01_mcu.kicad_sch, 02_power.kicad_sch, 03_epaper-driver.kicad_sch, 04_sd-card.kicad_sch, 05_control-buttons.kicad_sch, ZEReader-Pico.kicad_pcb, ZEReader-Pico.kicad_sch]
2025-02-04 issue in kibot config
    [zereader-pico.kibot.yaml]
2025-02-04 fix selfcontained and kibot output
    [01_mcu.kicad_sch, 02_power.kicad_sch]
2025-02-04 switched to self-contained symbols, update kibot conf
    [01_mcu.kicad_sch, 02_power.kicad_sch]
2025-02-04 fix selfcontainment issues, added 2D rendering
    [01_mcu.kicad_sch, 02_power.kicad_sch, 03_epaper-driver.kicad_sch, ZEReader-Pico.kicad_pcb]
2025-02-04 selfcontaining, KiBot output
    [02_power.kicad_sch, ZEReader-Pico.kicad_pcb]
2025-02-04 selfcontainment, smaller fixes
    [02_power.kicad_sch, 03_epaper-driver.kicad_sch, ZEReader-Pico.kicad_pcb]
2025-02-04 selfcontainment fixes
    [01_mcu.kicad_sch, 02_power.kicad_sch, 03_epaper-driver.kicad_sch, 05_control-buttons.kicad_sch]
2025-02-04 Imported Aisler design rules, routed power and display booster
    [01_mcu.kicad_sch, 02_power.kicad_sch, 03_epaper-driver.kicad_sch, 04_sd-card.kicad_sch, ZEReader-Pico.kicad_pcb]
2025-02-05 Initial routing finished
    [ZEReader-Pico.kicad_pcb]
2025-02-05 Changed USB connector due to manufacturing rule violations
    [02_power.kicad_sch, ZEReader-Pico.kicad_pcb]
2025-02-05 Worked on Design, eliminating errors
    [02_power.kicad_sch, ZEReader-Pico.kicad_pcb]
2025-02-07 updated KiBot tasks
    [ZEReader-Pico.kicad_pcb]
2025-02-07 fix: corrected button/connector location
    [ZEReader-Pico.kicad_pcb]
2025-02-07 try alternate display connector
    [03_epaper-driver.kicad_sch, ZEReader-Pico.kicad_pcb]
2025-02-10 Reordered and rerouted display charge pump part
    [03_epaper-driver.kicad_sch, 05_control-buttons.kicad_sch, ZEReader-Pico.kicad_pcb]
2025-02-10 Redesigned SD Reader and Buttons
    [04_sd-card.kicad_sch, 05_control-buttons.kicad_sch, ZEReader-Pico.kicad_pcb]
2025-02-11 Rerouted whole PCB
    [02_power.kicad_sch, 04_sd-card.kicad_sch, ZEReader-Pico.kicad_pcb]
2025-02-11 Also generate a PCB Design pdf
2025-02-11 try to fix pcb sheet export
    [zereader-pico.kibot.yaml]
2025-02-11 hopefully generate the expected PCB output
2025-02-11 Fix some parts of PCB sheet generation
    [zereader-pico.kibot.yaml]
2025-02-11 Remove unneeded layers from PCB design output
2025-02-11 fix pcb sheet generation
    [zereader-pico.kibot.yaml]
2025-02-11 moved display booster part down do get some space on the upper edge
    [ZEReader-Pico.kicad_pcb]
2025-02-11 Changed USB-C connector due to availability issues
    [02_power.kicad_sch, ZEReader-Pico.kicad_pcb]
2025-02-12 cleanup silkscreen and alignments
    [ZEReader-Pico.kicad_pcb]
2025-02-12 Move display connector, give the flex cable more slack
    [ZEReader-Pico.kicad_pcb]
2025-02-12 Small Silkscreen updates
    [ZEReader-Pico.kicad_pcb]
2025-02-12 Rerouted two parts
    [ZEReader-Pico.kicad_pcb]
2025-02-12 Optimized track lengths
    [ZEReader-Pico.kicad_pcb]
2025-02-12 Add kicad_pcb to CI outputs
    [ZEReader-Pico.kicad_pcb]
2025-02-12 Fix Fab output generation
    [zereader-pico.kibot.yaml]
2025-02-12 Use sed for variable replacement
    [01_mcu.kicad_sch, 02_power.kicad_sch, 03_epaper-driver.kicad_sch, 04_sd-card.kicad_sch, 05_control-buttons.kicad_sch, ZEReader-Pico.kicad_pcb, ZEReader-Pico.kicad_sch]
2025-03-07 fix: Adds ToDos for issues in the current design
    [02_power.kicad_sch, 03_epaper-driver.kicad_sch]
2025-06-06 updated some values after testing out tuning details
    [02_power.kicad_sch, 03_epaper-driver.kicad_sch, 04_sd-card.kicad_sch, 05_control-buttons.kicad_sch]
2025-07-23 some cleanup, added pictures
    [02_power.kicad_sch, 03_epaper-driver.kicad_sch, 04_sd-card.kicad_sch]
2025-07-23 doc: add PCB rendering in readme
2025-08-17 Migrate to KiCad 9, start working on the new revision
    [01_mcu.kicad_sch, 02_power.kicad_sch, 03_epaper-driver.kicad_sch, 04_sd-card.kicad_sch, 05_control-buttons.kicad_sch, ZEReader-Pico.kicad_pcb, ZEReader-Pico.kicad_sch]
2025-08-19 reworked epaper-driver schematic - corrected inverted ffc adapter
    [01_mcu.kicad_sch, 02_power.kicad_sch, 03_epaper-driver.kicad_sch, 04_sd-card.kicad_sch, 05_control-buttons.kicad_sch, ZEReader-Pico.kicad_pcb]
2025-08-19 switch to KiCad Pico extended symbol
    [01_mcu.kicad_sch, 03_epaper-driver.kicad_sch, 04_sd-card.kicad_sch, ZEReader-Pico.kicad_pcb]
2025-08-19 fully connect the sd connector, redraw sd and buttons
    [01_mcu.kicad_sch, 03_epaper-driver.kicad_sch, 04_sd-card.kicad_sch, 05_control-buttons.kicad_sch, ZEReader-Pico.kicad_pcb, ZEReader-Pico.kicad_sch]
2025-08-20 updated power path, connect USB-C to pico's USB data
    [01_mcu.kicad_sch, 02_power.kicad_sch, 03_epaper-driver.kicad_sch, ZEReader-Pico.kicad_pcb, ZEReader-Pico.kicad_sch]
2025-09-05 v2: major changes
    - Move to hierarchical labels
    - use another RP Pico Footprint
    - split power path in USB/charging and on/off with a button approach in order to control turning on and off
    with the RP Pico, make use of long presses and delay turning of the voltage in order to do a proper shutdown
    - introduce another charging controller with a better performance an a lower voltage needed in order to charge the battery
    - rework display booster circuit
    - rework SD and buttons
    [01_mcu.kicad_sch, 02a_usb-battery-charging.kicad_sch, 02b-Power-On-Off.kicad_sch, 03_epaper-driver.kicad_sch, 04_sd-card.kicad_sch, 05_control-buttons.kicad_sch, ZEReader-Pico.kicad_pcb, ZEReader-Pico.kicad_sch]
2025-09-25 Worked on power on/off button, epaper driver and board/routing
    [02b-Power-On-Off.kicad_sch, 03_epaper-driver.kicad_sch, ZEReader-Pico.kicad_pcb]
2025-10-24 v2: finished schematics, start routing
    The schematics for v2 should be mostly finished by now.
    The new on/off button is ready and tested with a breadboard setup.
    It now uses two FETs for a self-holding circuit for turning the
    device on and off. To reach a safe logic level for Pico 2, a
    2.7V Zener diode is used together with a pull-down for E9 affected
    RP2350 revisions.
    Besides, most pull-up resistors are 10k now to keep the BoM
    smaller.
    Routing started with a major redesign.
    [01_mcu.kicad_sch, 02b-Power-On-Off.kicad_sch, 03_epaper-driver.kicad_sch, 04_sd-card.kicad_sch, 05_control-buttons.kicad_sch, ZEReader-Pico.kicad_pcb]
2025-11-01 First routing approach for v2
    [02b-Power-On-Off.kicad_sch, ZEReader-Pico.kicad_pcb]
2025-11-02 Update routing and Kibot version
    [02a_usb-battery-charging.kicad_sch, 02b-power-on-off.kicad_sch, ZEReader-Pico.kicad_pcb]
2025-11-07 Reworked v2 routing
    - some general improvements
    - reworked component numbering
    - routed and tuned differential pair (USB)
    - added stiching vias and improved ground fills
    [01_mcu.kicad_sch, 02a_usb-battery-charging.kicad_sch, 02b-Power-On-Off.kicad_sch, 02b-power-on-off.kicad_sch, 03_epaper-driver.kicad_sch, 04_sd-card.kicad_sch, 05_control-buttons.kicad_sch, ZEReader-Pico.kicad_pcb]
2025-11-07 some minor improvements after evaluating the CI run
    [01_mcu.kicad_sch, 02a_usb-battery-charging.kicad_sch, 02b-Power-On-Off.kicad_sch, 02b-power-on-off.kicad_sch, 03_epaper-driver.kicad_sch, 04_sd-card.kicad_sch, 05_control-buttons.kicad_sch, ZEReader-Pico.kicad_pcb]
2025-11-07 reapplied the KiCad Logo
    [ZEReader-Pico.kicad_pcb]
2025-11-09 v2: final touch
    - add proper ESD diodes for USB
    - move the USB fuse right after the connector
    - pretty labels for test points
    [02a_usb-battery-charging.kicad_sch, 02b-Power-On-Off.kicad_sch, 02b-power-on-off.kicad_sch, 03_epaper-driver.kicad_sch, 04_sd-card.kicad_sch, ZEReader-Pico.kicad_pcb]
2025-11-09 mirrored front side logo
    [ZEReader-Pico.kicad_pcb]
2025-11-09 better integration for the USB ESD diodes, better trace length matching
    [02a_usb-battery-charging.kicad_sch, ZEReader-Pico.kicad_pcb, ZEReader-Pico.kicad_sch]
2025-11-14 fix two labeling issues
    [ZEReader-Pico.kicad_pcb]
2025-11-18 Connect both USB data lines again, checked everything with datasheets again
    [01_mcu.kicad_sch, 02a_usb-battery-charging.kicad_sch, 02b-Power-On-Off.kicad_sch, 02b-power-on-off.kicad_sch, 03_epaper-driver.kicad_sch, 04_sd-card.kicad_sch, 05_control-buttons.kicad_sch, ZEReader-Pico.kicad_pcb]
2025-11-18 rewrite the project's readme and update it for rev2
    [ZEReader-Pico.kicad_pcb]
2025-11-19 Updated zener diode footprint
    [02b-Power-On-Off.kicad_sch, 02b-power-on-off.kicad_sch, ZEReader-Pico.kicad_pcb]
2025-11-20 Reworked the PCB after review
    [01_mcu.kicad_sch, 02a_usb-battery-charging.kicad_sch, 02b-power-on-off.kicad_sch, 03_epaper-driver.kicad_sch, 04_sd-card.kicad_sch, ZEReader-Pico.kicad_pcb, ZEReader-Pico.kicad_sch]
2025-11-21 Bigger Zener, improved BoM, general improvements
    [01_mcu.kicad_sch, 02a_usb-battery-charging.kicad_sch, 02b-power-on-off.kicad_sch, 03_epaper-driver.kicad_sch, 04_sd-card.kicad_sch, 05_control-buttons.kicad_sch, ZEReader-Pico.kicad_pcb, ZEReader-Pico.kicad_sch]
2025-11-21 Removed unneeded paste under Pi Pico, updated KiBot BoM generation
    [ZEReader-Pico.kicad_pcb]
2025-11-21 Add missing git rev variable in one schematic file, updated BOM generation
    [02b-power-on-off.kicad_sch]
2025-11-30 Add proper charging detection, fix zener footprint
    Connect the BQ25 status pin to the microcontroller for a proper
    charging detection (low active).
    Correct the footprint for the selected zener diode.
    Somehow, the wrong footprint got assigned.
    [01_mcu.kicad_sch, 02a_usb-battery-charging.kicad_sch, 02b-power-on-off.kicad_sch, ZEReader-Pico.kicad_pcb, ZEReader-Pico.kicad_sch, ZEReaderPicov2.FCStd]
2025-12-06 Avoid using the ADC pins for anything but ADC tasks
    [01_mcu.kicad_sch, 02a_usb-battery-charging.kicad_sch, ZEReader-Pico.kicad_pcb]
2025-12-09 Add an voltage bypass mode when USB-C is connected
    When USB-C is connected, the device should be charging, but also powered,
    without taking care of the on/off button's state.
    Otherwise, flashing the device via USB-C would only be
    possible as long as the button is pressed which makes the usage
    experience a mess and flaky.
    This uses p-MOSFETs to do the switch and
    a) avoid a battery voltage going to the system when USB-C is connected
    b) avoid powering having both, USB-C and Micro-USB active
    TODO: This adds the basic idea, routing must be fixed!
    [01_mcu.kicad_sch, 02a_usb-battery-charging.kicad_sch, 02b-power-on-off.kicad_sch, 03_epaper-driver.kicad_sch, ZEReader-Pico.kicad_pcb, ZEReader-Pico.kicad_sch]
2026-01-08 Introduce KiCad native Jobsets as an alternative to KiBot
    Adds KiCad a jobset together with a new GitHub workflow file
    to generate the project outputs without external tooling.
    Some general work on the USB-Powerpath routing.
    [02b-power-on-off.kicad_sch, ZEReader-Pico.kicad_pcb, ZEReaderPicov2.FCStd]
2026-02-01 Add known issues for the ZEReader V2 PCB
    The ZEReader V2 PCB is manufactured and tested since 12/2025,
    so it was about time to add known issues for this version.
    [02_power.kicad_sch]
